quantumFeline/autocad-experiment/E-Nable - Thumb prosthesis - 2874072/images/Thumb_2.jpg

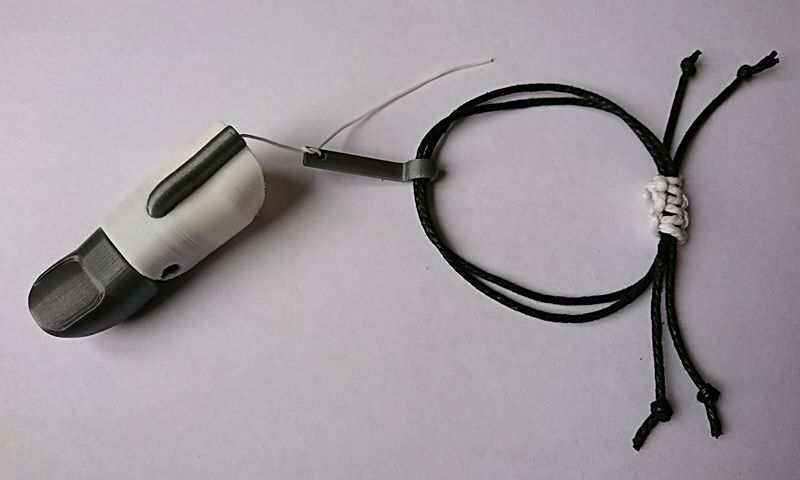
E-Nable - Thumb prosthesis - 2874072/images/Thumb_2.jpg
