quantumFeline/autocad-experiment/E-Nable - Thumb prosthesis - 2874072/images/5984bfd787b6ed34e9f9d07957b7ba69.png

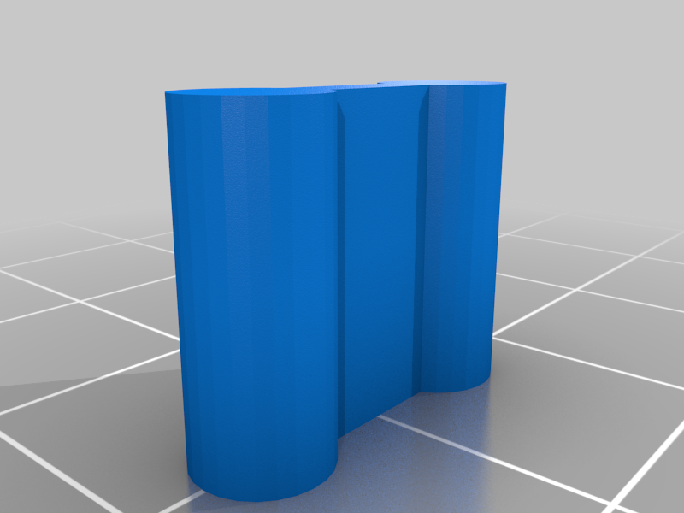
E-Nable - Thumb prosthesis - 2874072/images/5984bfd787b6ed34e9f9d07957b7ba69.png
