quantumFeline/autocad-experiment/README.md

A check whether you can vibecode something useful in autocad.
the baseline models are licensed by CC-BY-NC-SA can can be found here:
https://www.thingiverse.com/thing:2874072/files
https://www.thingiverse.com/thing:1340624/files
