quantumFeline/autocad-experiment/design/clean_sketch.png

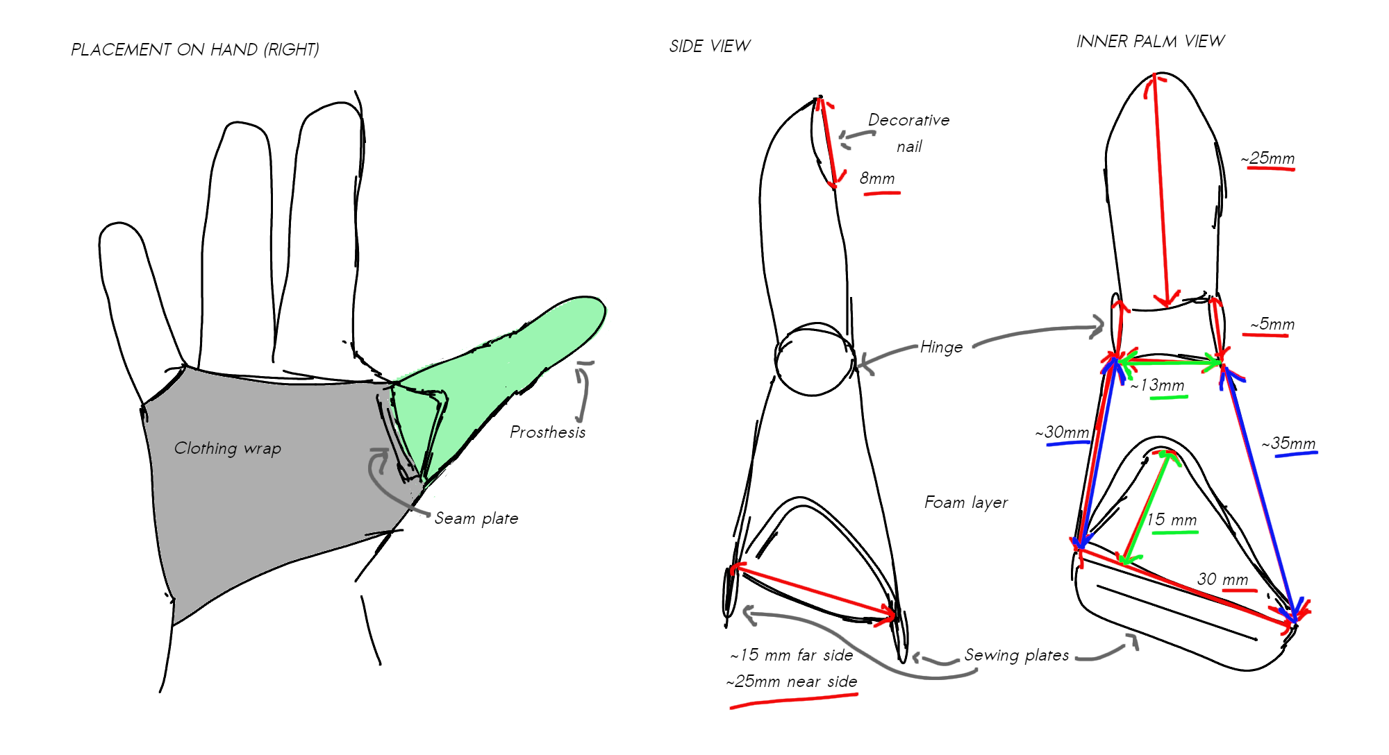
design/clean_sketch.png
