quantumFeline/autocad-experiment/design/clean_sketch_front_view.png

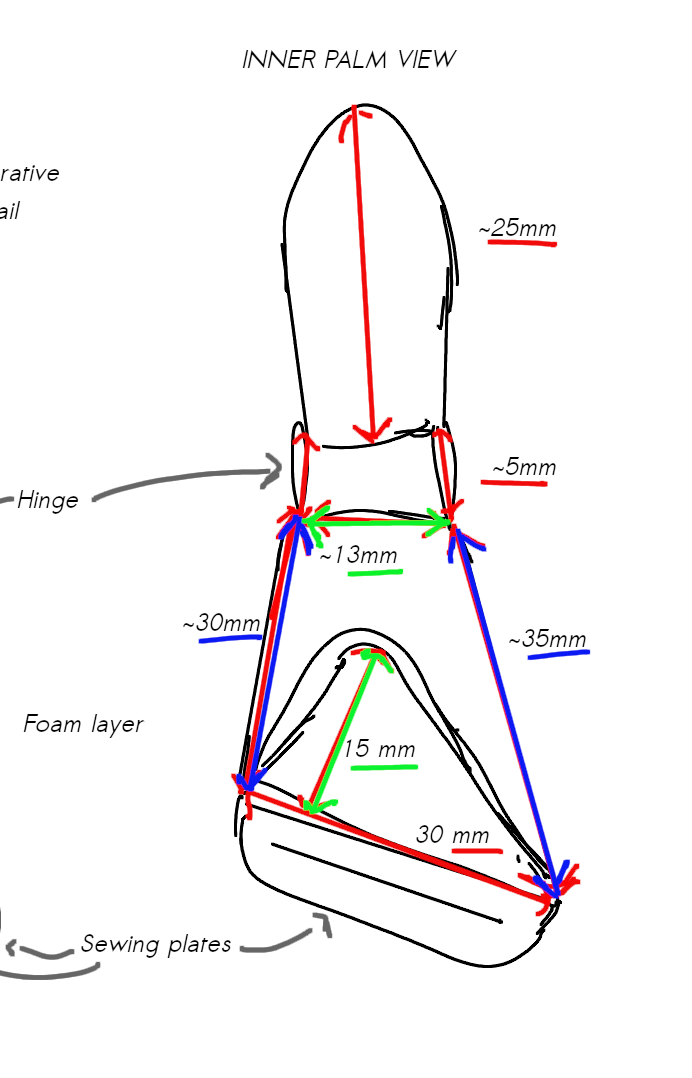
design/clean_sketch_front_view.png
