quantumFeline/autocad-experiment/design/clean_sketch_side_view.png

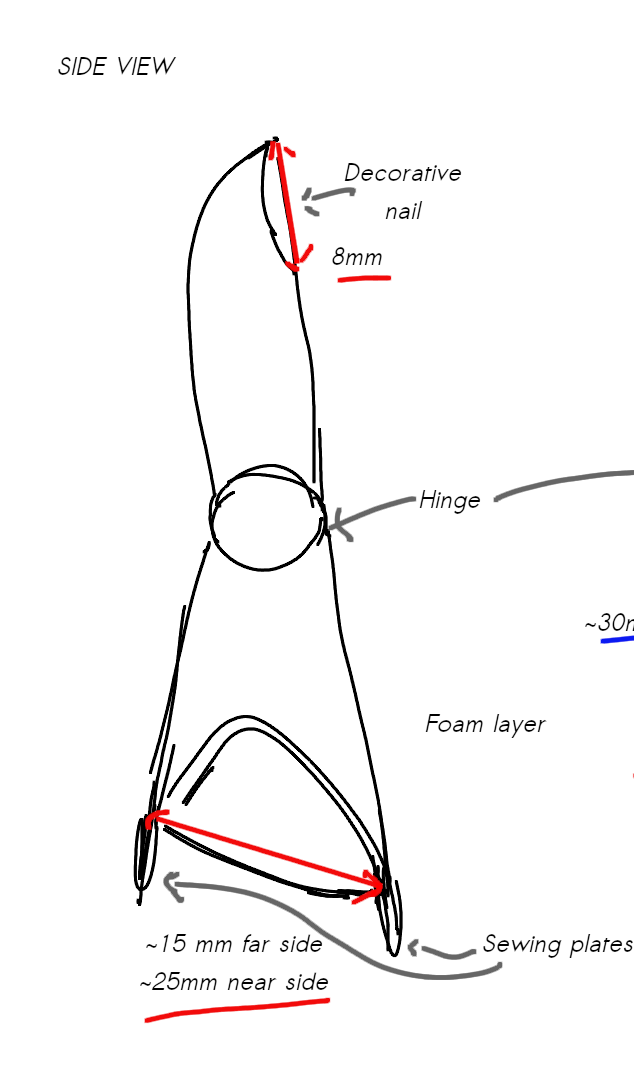
design/clean_sketch_side_view.png
