quantumFeline/autocad-experiment/design/sketch.jpeg

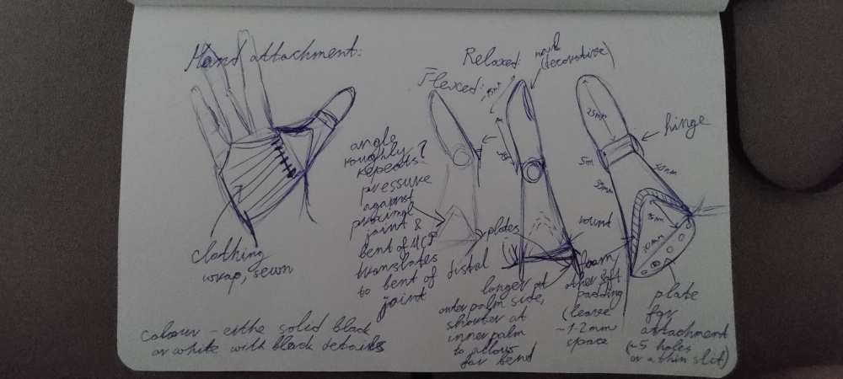
design/sketch.jpeg
