quantumFeline/autocad-experiment/E-Nable - Thumb prosthesis - 2874072/images/54ded9b1bef4dffa997f324771f008ee.png

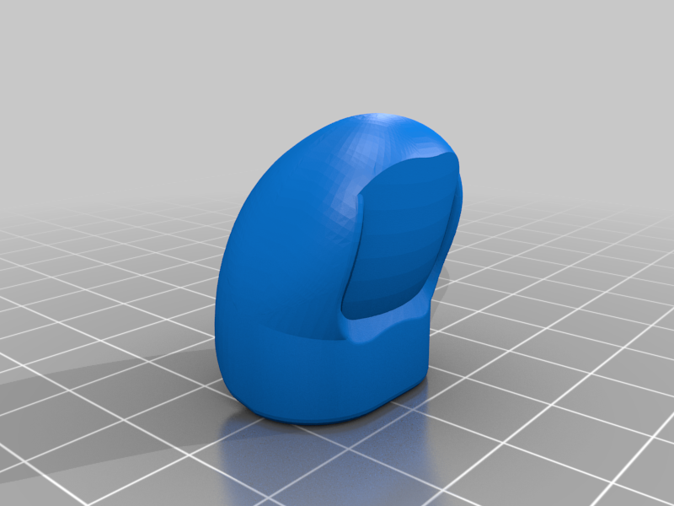
E-Nable - Thumb prosthesis - 2874072/images/54ded9b1bef4dffa997f324771f008ee.png
