quantumFeline/autocad-experiment/E-Nable - Thumb prosthesis - 2874072/images/613c3b29e1af66e0564f195f7e7fa3b6.png

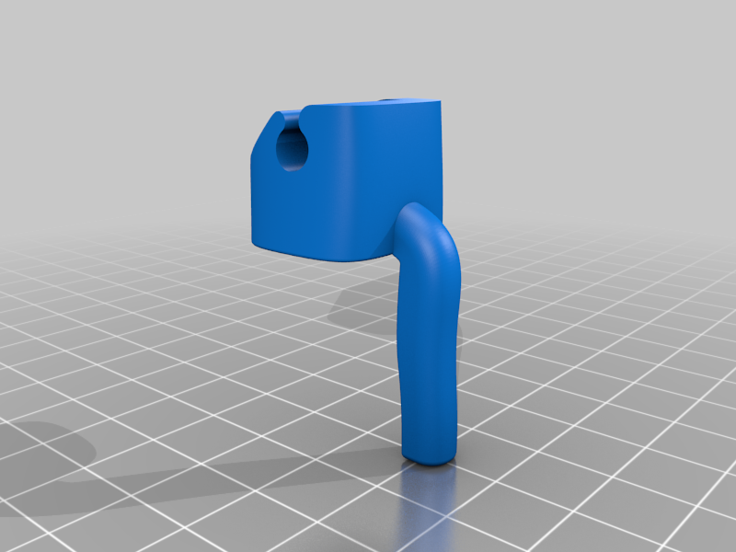
E-Nable - Thumb prosthesis - 2874072/images/613c3b29e1af66e0564f195f7e7fa3b6.png
