quantumFeline/autocad-experiment/E-Nable - Thumb prosthesis - 2874072/images/51340d938d2599c457b8b2ca0dacd941.png

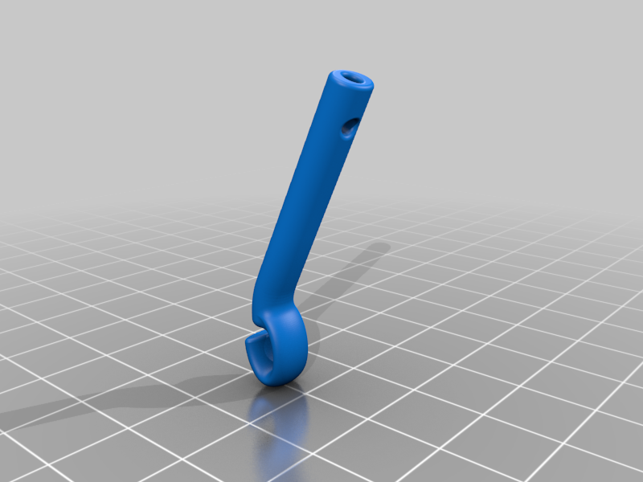
E-Nable - Thumb prosthesis - 2874072/images/51340d938d2599c457b8b2ca0dacd941.png
