quantumFeline/autocad-experiment/E-Nable - Thumb prosthesis - 2874072/images/22830366244676ff3c5c635549c43304.png

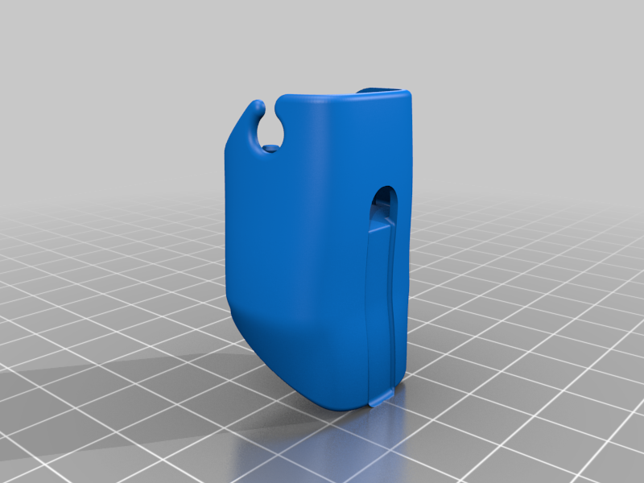
E-Nable - Thumb prosthesis - 2874072/images/22830366244676ff3c5c635549c43304.png
