quantumFeline/autocad-experiment/E-Nable - Thumb prosthesis - 2874072/images/Thumb_1.JPG

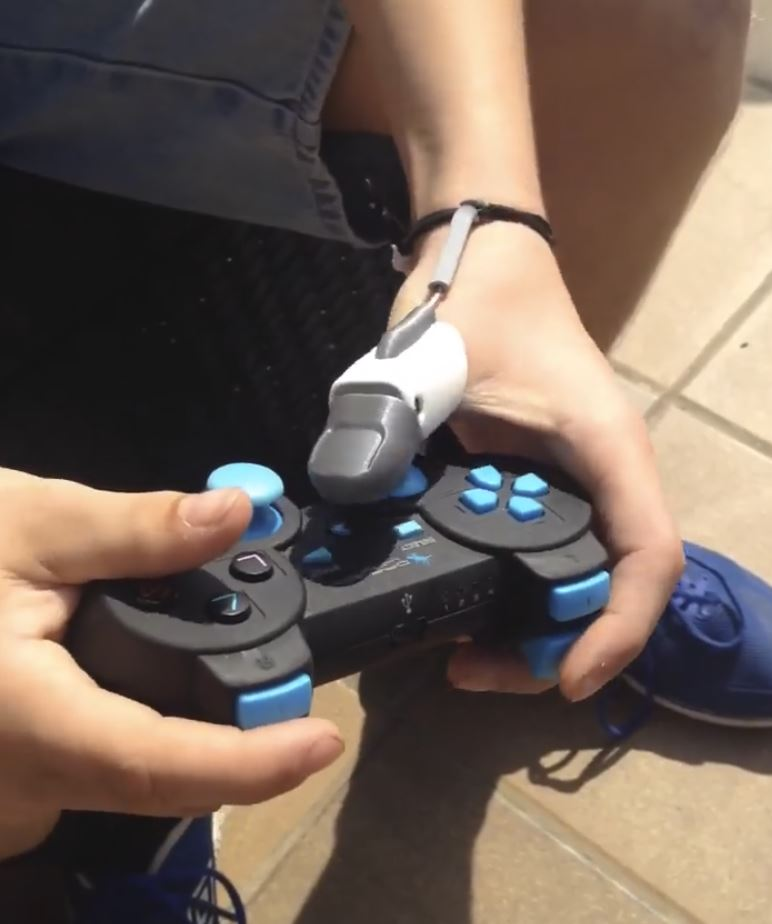
E-Nable - Thumb prosthesis - 2874072/images/Thumb_1.JPG
