quantumFeline/autocad-experiment/E-Nable - Thumb prosthesis - 2874072/images/Thumb_4.jpg

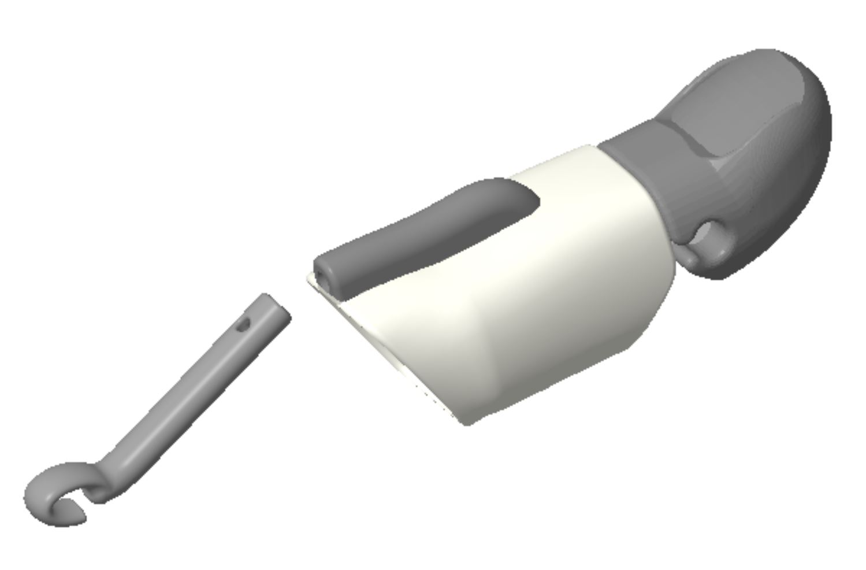
E-Nable - Thumb prosthesis - 2874072/images/Thumb_4.jpg
