quantumFeline/autocad-experiment/E-Nable - Thumb prosthesis - 2874072/images/Thumb_6.jpg

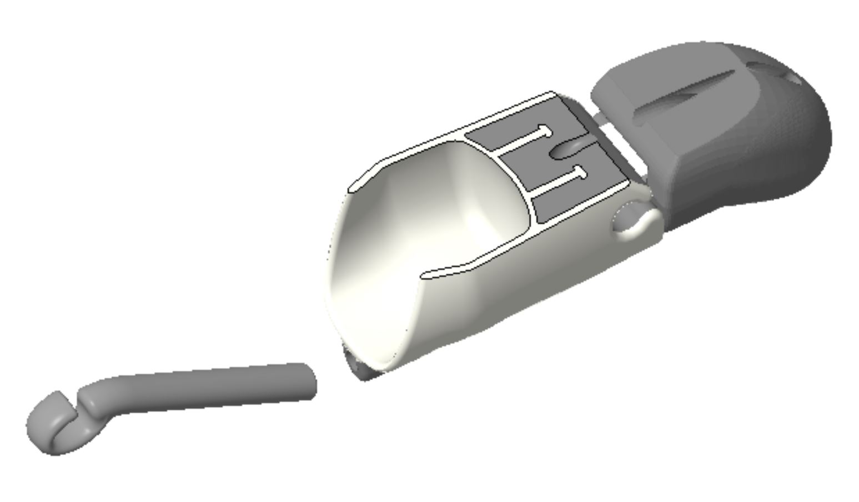
E-Nable - Thumb prosthesis - 2874072/images/Thumb_6.jpg
