quantumFeline/autocad-experiment/Knick's Prosthetic Finger v3.5.5 - 1340624/images/1c6031880f59359c41b101f5cd64a22d.png

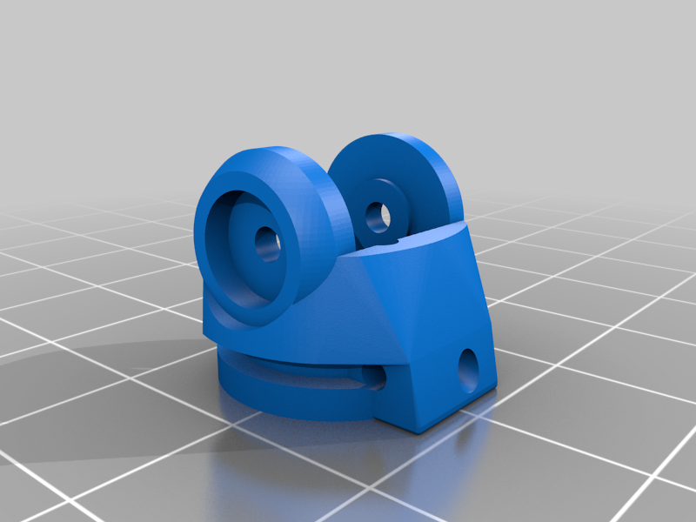
Knick's Prosthetic Finger v3.5.5 - 1340624/images/1c6031880f59359c41b101f5cd64a22d.png
