quantumFeline/autocad-experiment/Knick's Prosthetic Finger v3.5.5 - 1340624/images/5b853dfa50b55dad21bc6646ecabebe9.png

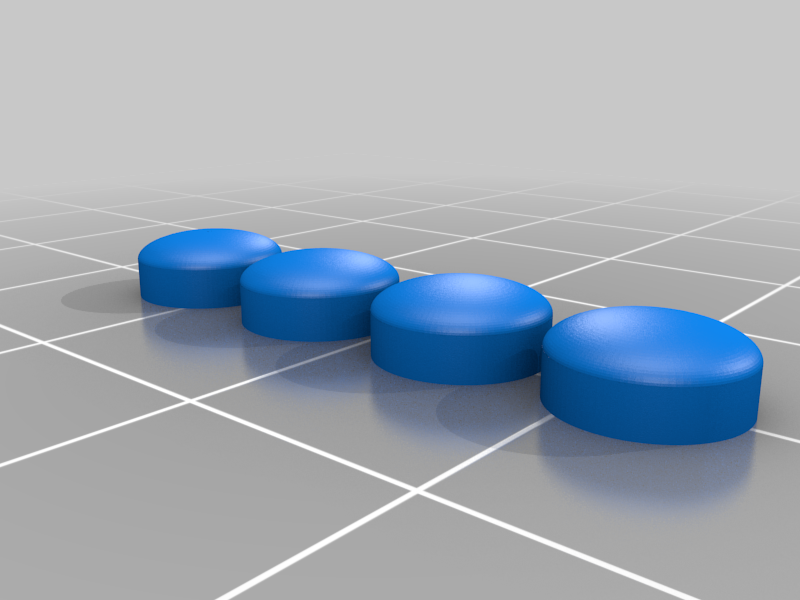
Knick's Prosthetic Finger v3.5.5 - 1340624/images/5b853dfa50b55dad21bc6646ecabebe9.png
