quantumFeline/autocad-experiment/Knick's Prosthetic Finger v3.5.5 - 1340624/images/9d57aa2e5c853061dc81193ec92a0d61.png

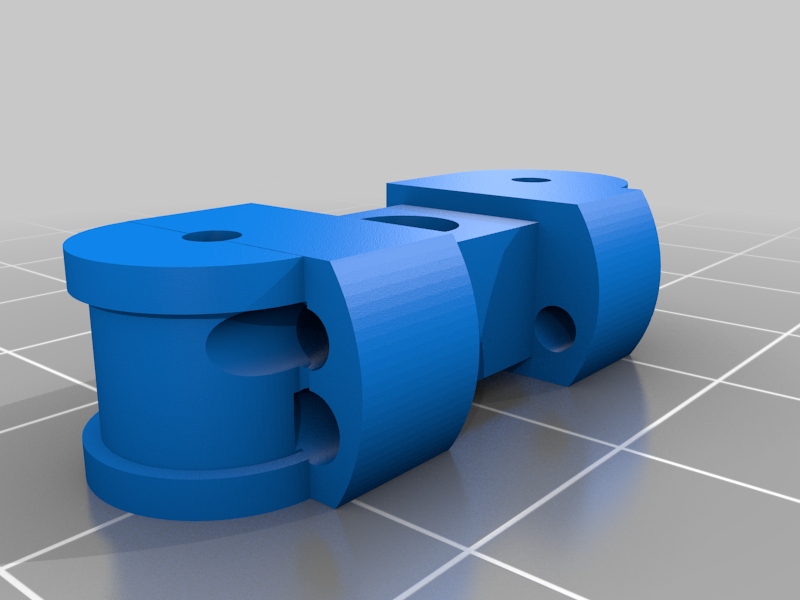
Knick's Prosthetic Finger v3.5.5 - 1340624/images/9d57aa2e5c853061dc81193ec92a0d61.png
