quantumFeline/autocad-experiment/Knick's Prosthetic Finger v3.5.5 - 1340624/images/25e89b2fef497850f5a763c68ce37bf3.png

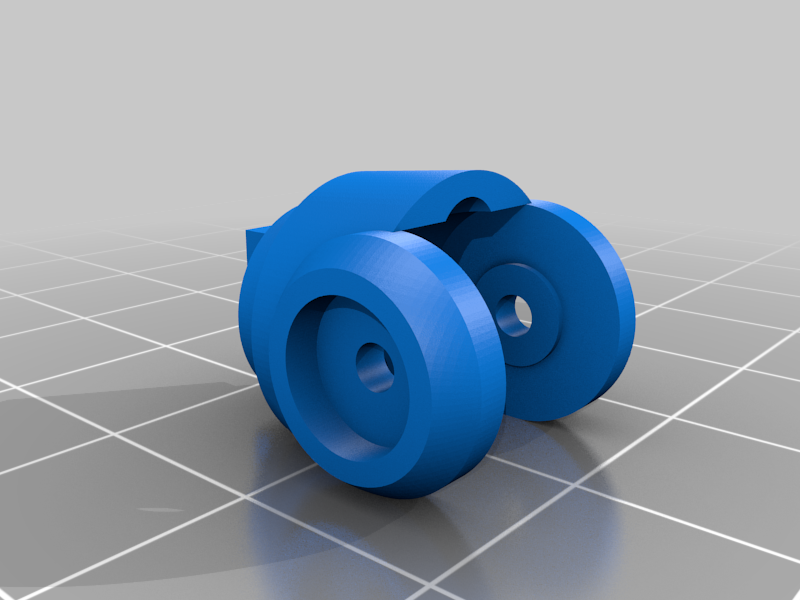
Knick's Prosthetic Finger v3.5.5 - 1340624/images/25e89b2fef497850f5a763c68ce37bf3.png
