quantumFeline/autocad-experiment/Knick's Prosthetic Finger v3.5.5 - 1340624/images/881f93b1ac3e0c698e7ac5b91a7e6feb.png

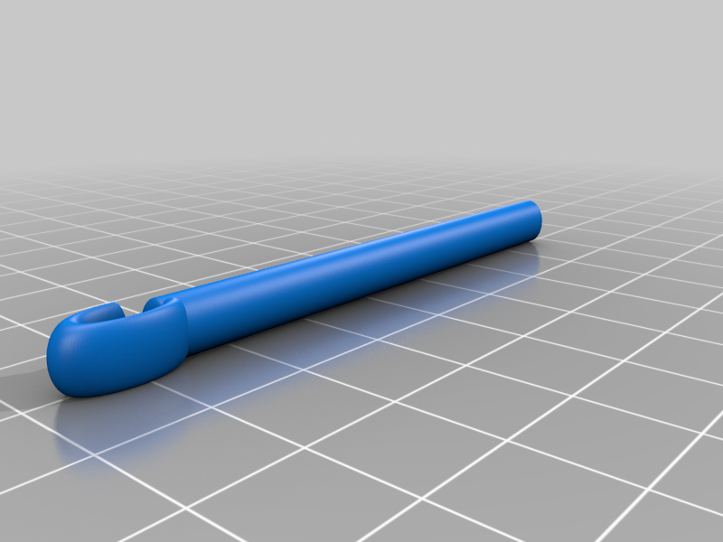
Knick's Prosthetic Finger v3.5.5 - 1340624/images/881f93b1ac3e0c698e7ac5b91a7e6feb.png
