quantumFeline/autocad-experiment/Knick's Prosthetic Finger v3.5.5 - 1340624/images/efcd1fd4c4c2df468a20345ef2f9840b.png

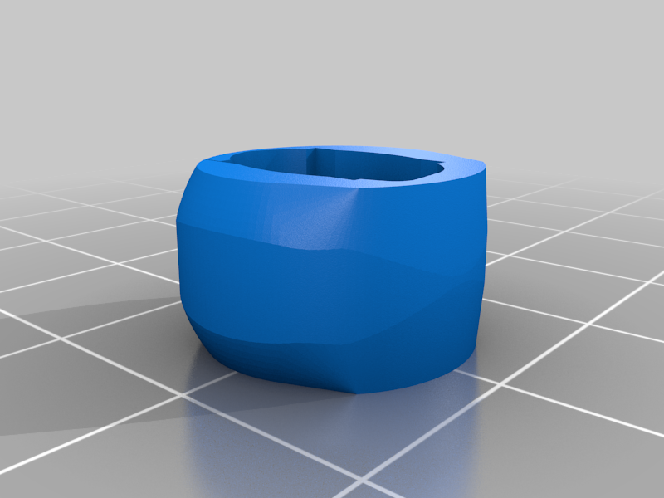
Knick's Prosthetic Finger v3.5.5 - 1340624/images/efcd1fd4c4c2df468a20345ef2f9840b.png
