quantumFeline/autocad-experiment/Knick's Prosthetic Finger v3.5.5 - 1340624/images/IMG_5169.jpg

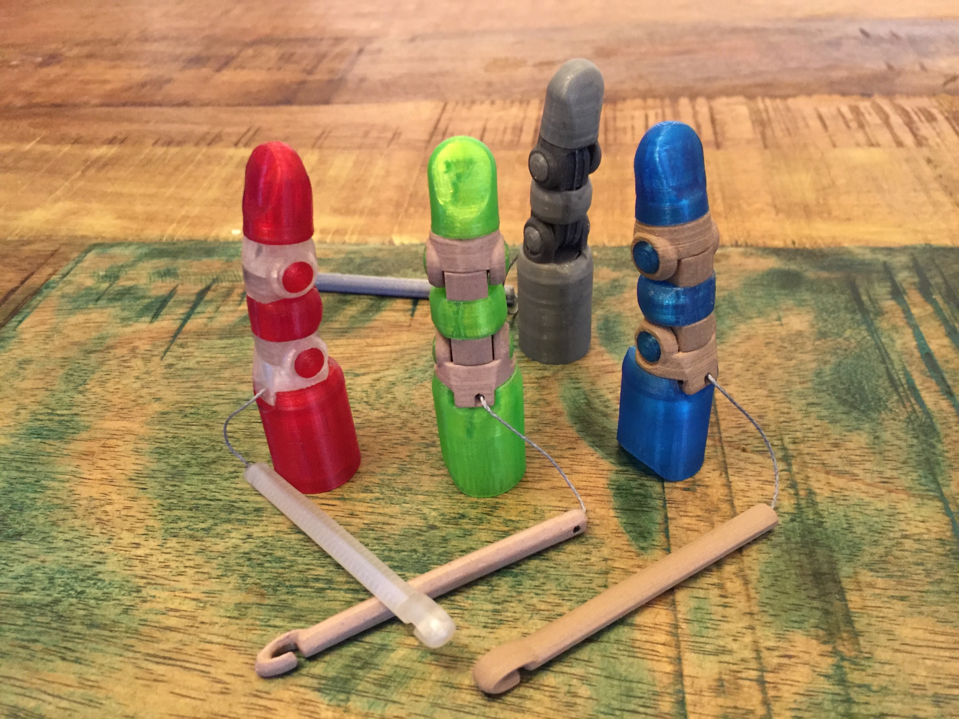
Knick's Prosthetic Finger v3.5.5 - 1340624/images/IMG_5169.jpg
