quantumFeline/autocad-experiment/Knick's Prosthetic Finger v3.5.5 - 1340624/images/Screen_Shot_2016-02-13_at_9.30.39_PM.png

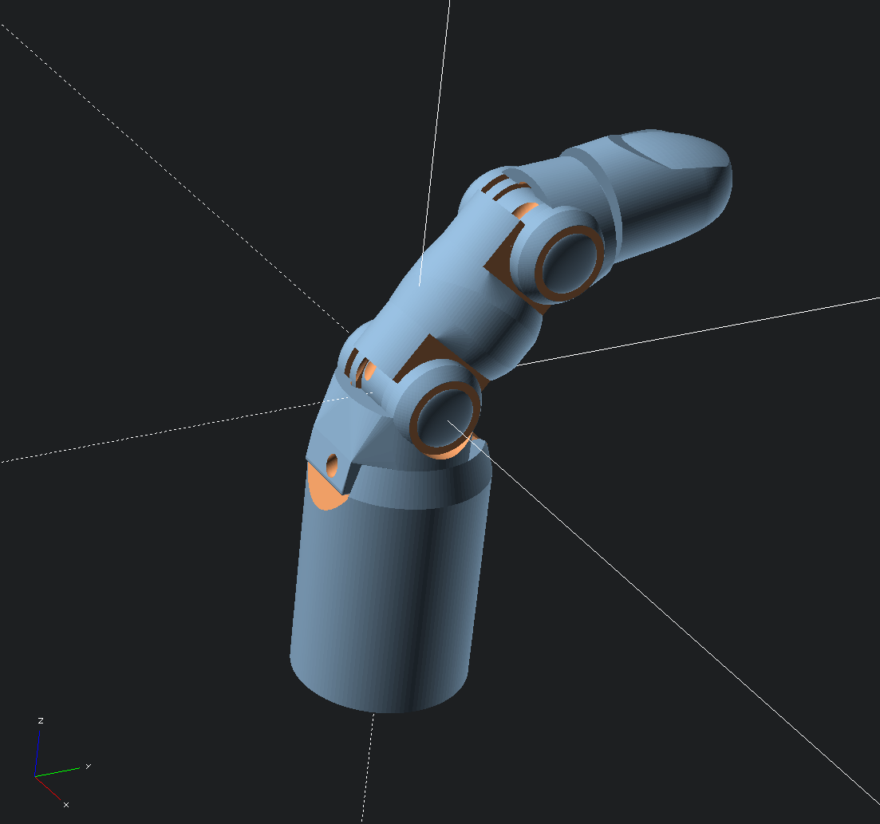
Knick's Prosthetic Finger v3.5.5 - 1340624/images/Screen_Shot_2016-02-13_at_9.30.39_PM.png
