quantumFeline/autocad-experiment/E-Nable - Thumb prosthesis - 2874072/files/thumb_prothese_v2_asm.stp

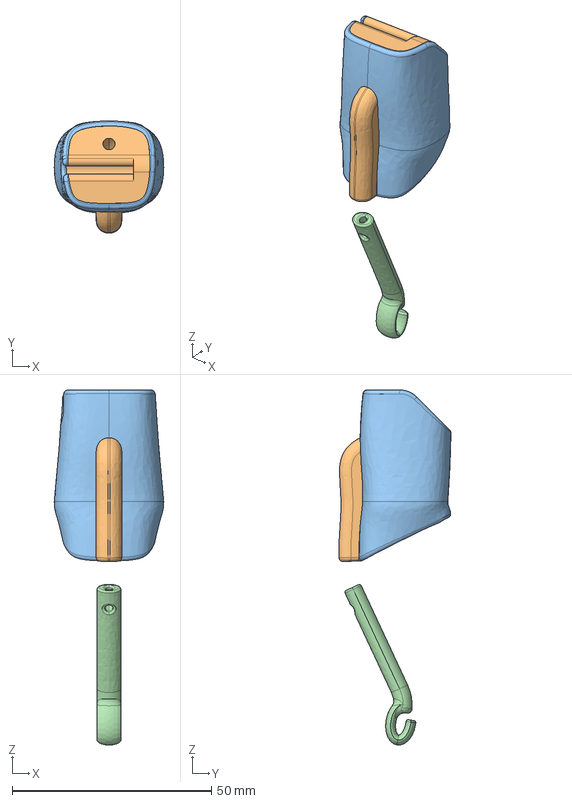
[picture p30: CAD file, 2026-07-03]
E-Nable - Thumb prosthesis - 2874072/files/thumb_prothese_v2_asm.stp
27.5 x 28.1 x 89.0 mm
THUMB_PHALANX_PLA_V2
THUMB_PHALANX_TPU_V2_
FLEXI_THUMB_PHALANX_V2
FLEXI_HINGE_8_V2
FLEXI_THUMB_V2
THUMB_LINKAGE_V2
HAND_V2
