quantumFeline/autocad-experiment/Knick's Prosthetic Finger v3.5.5 - 1340624/files/finger_plugs_v3.5.1.stl

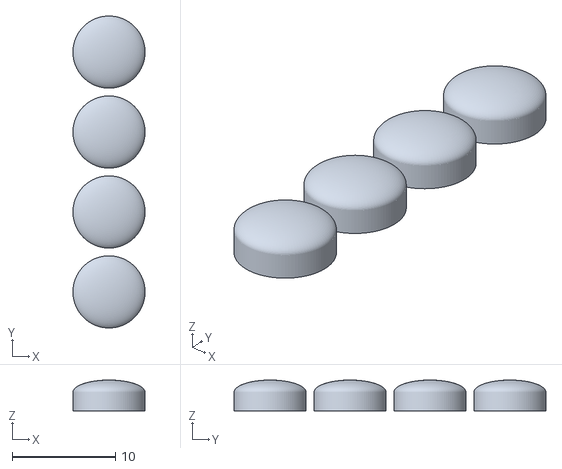
[picture p31: CAD file, 2026-07-03]
Knick's Prosthetic Finger v3.5.5 - 1340624/files/finger_plugs_v3.5.1.stl
7.00 x 30.2 x 3.00
