quantumFeline/autocad-experiment/stl/print_all.stl

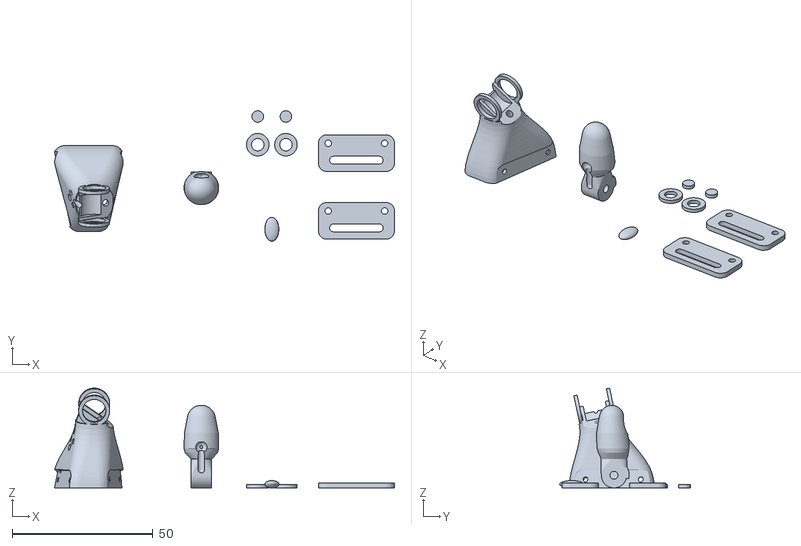
[picture p32: CAD file, 2026-08-21]
stl/print_all.stl
120.6 x 46.3 x 35.4
