quantumFeline/autocad-experiment/E-Nable - Thumb prosthesis - 2874072/files/flexi_thumb_v2.stl

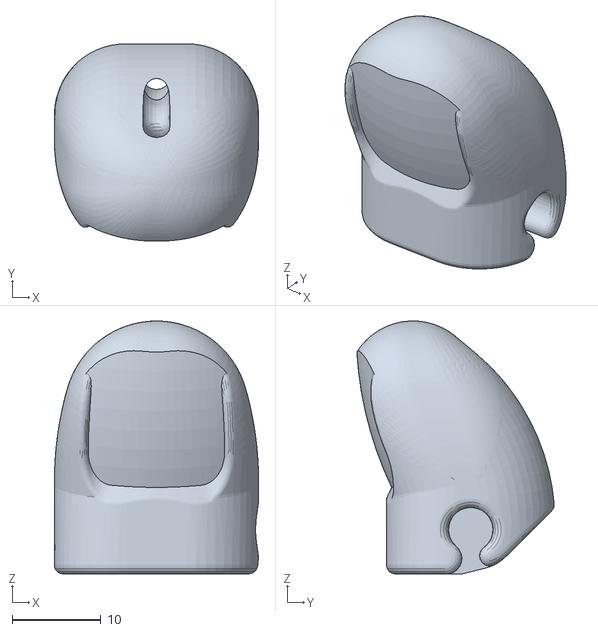
[picture p33: CAD file, 2026-07-03]
E-Nable - Thumb prosthesis - 2874072/files/flexi_thumb_v2.stl
23.0 x 22.3 x 28.5
