quantumFeline/autocad-experiment/Knick's Prosthetic Finger v3.5.5 - 1340624/files/finger_socket_v3.5.stl

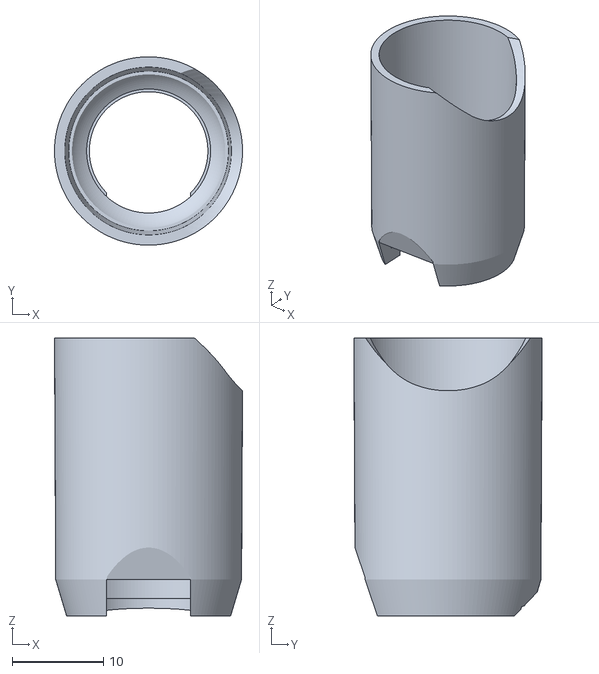
[picture p34: CAD file, 2026-07-03]
Knick's Prosthetic Finger v3.5.5 - 1340624/files/finger_socket_v3.5.stl
20.6 x 20.7 x 30.5
