quantumFeline/autocad-experiment/stl/disk_ring.stl

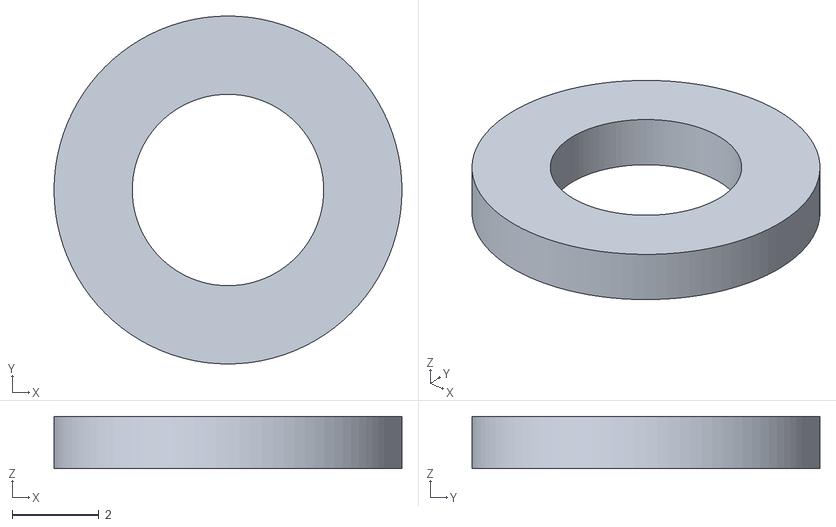
[picture p35: CAD file, 2026-08-21]
stl/disk_ring.stl
8.00 x 8.00 x 1.20
