quantumFeline/autocad-experiment/E-Nable - Thumb prosthesis - 2874072/files/flexi_hinge_8_v2.stl

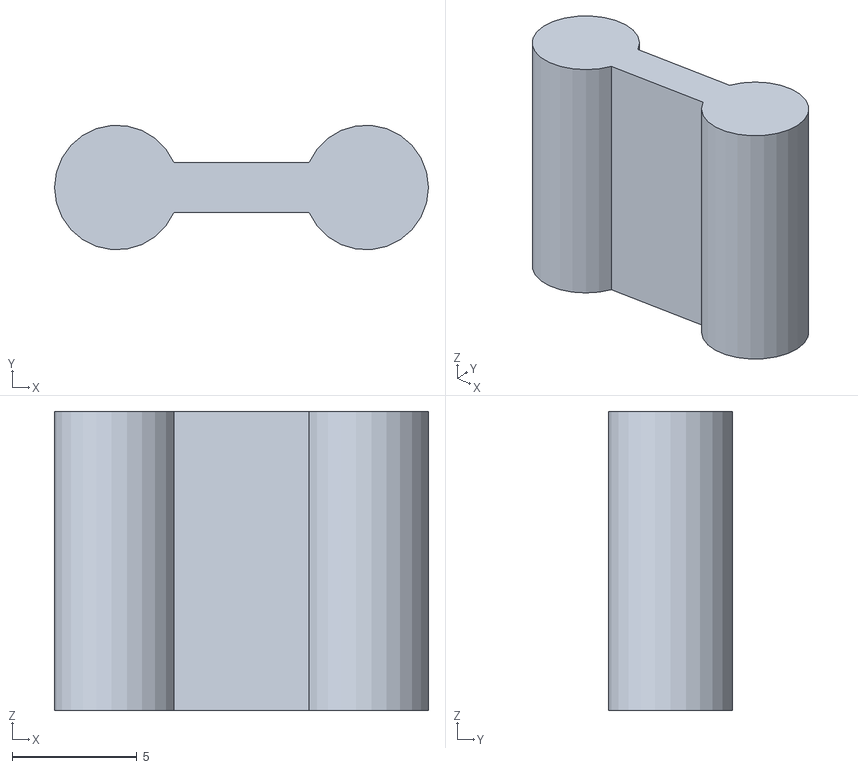
[picture p36: CAD file, 2026-07-03]
E-Nable - Thumb prosthesis - 2874072/files/flexi_hinge_8_v2.stl
15.0 x 4.99 x 12.0
