quantumFeline/autocad-experiment/Knick's Prosthetic Finger v3.5.5 - 1340624/files/finger_linkage_v3.5.stl

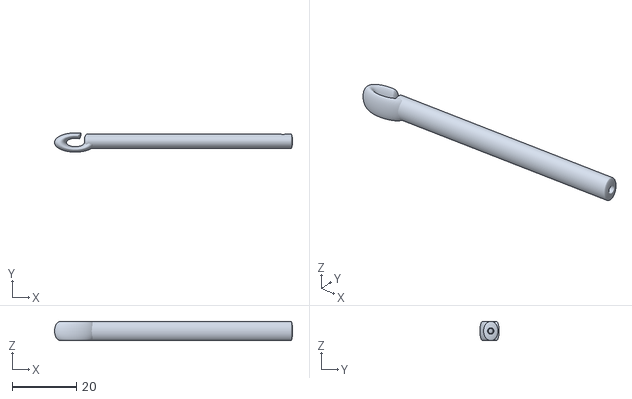
[picture p37: CAD file, 2026-07-03]
Knick's Prosthetic Finger v3.5.5 - 1340624/files/finger_linkage_v3.5.stl
74.2 x 6.00 x 6.00
