quantumFeline/autocad-experiment/stl/disk_plug.stl

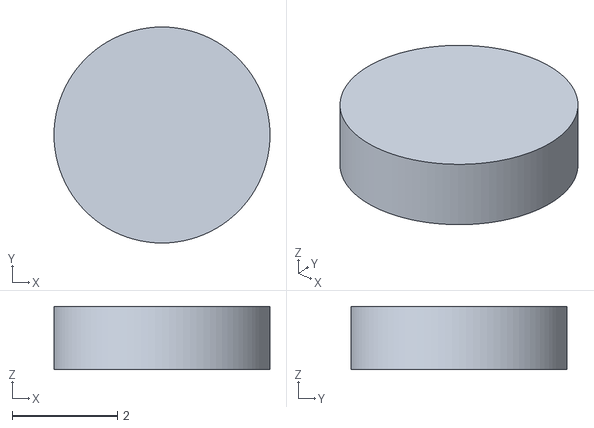
[picture p38: CAD file, 2026-08-21]
stl/disk_plug.stl
4.10 x 4.10 x 1.20
