quantumFeline/autocad-experiment/E-Nable - Thumb prosthesis - 2874072/files/thumb_linkage_v2.stl

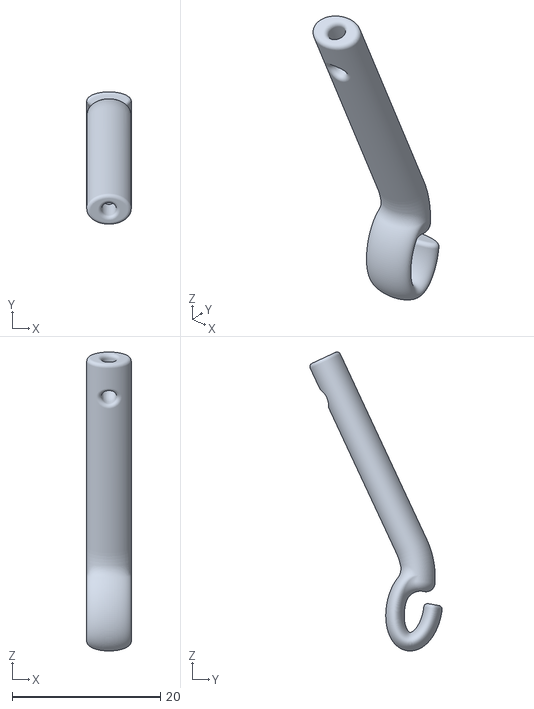
[picture p39: CAD file, 2026-07-03]
E-Nable - Thumb prosthesis - 2874072/files/thumb_linkage_v2.stl
6.00 x 17.8 x 40.3
