quantumFeline/autocad-experiment/Knick's Prosthetic Finger v3.5.5 - 1340624/files/finger_middle_v3.5.stl

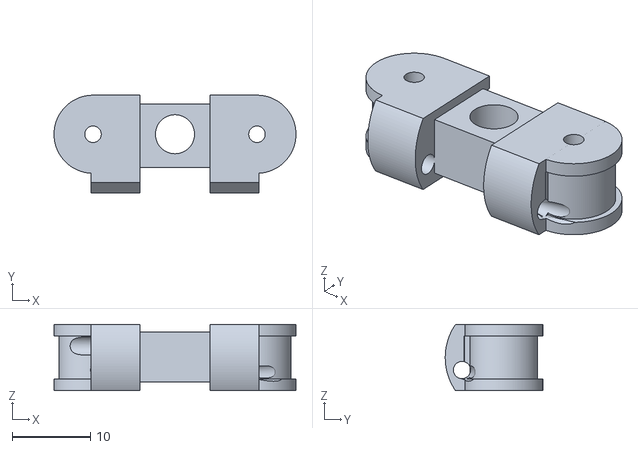
[picture p40: CAD file, 2026-07-03]
Knick's Prosthetic Finger v3.5.5 - 1340624/files/finger_middle_v3.5.stl
31.0 x 12.5 x 8.51
