quantumFeline/autocad-experiment/stl/nail.stl

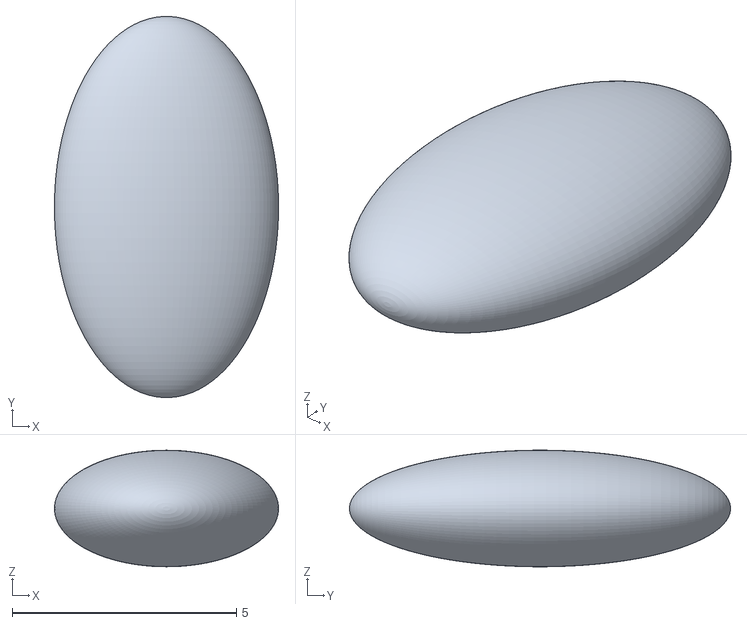
[picture p41: CAD file, 2026-08-21]
stl/nail.stl
5.00 x 8.50 x 2.60
