quantumFeline/autocad-experiment/E-Nable - Thumb prosthesis - 2874072/files/thumb_phalanx_pla_v2.stl

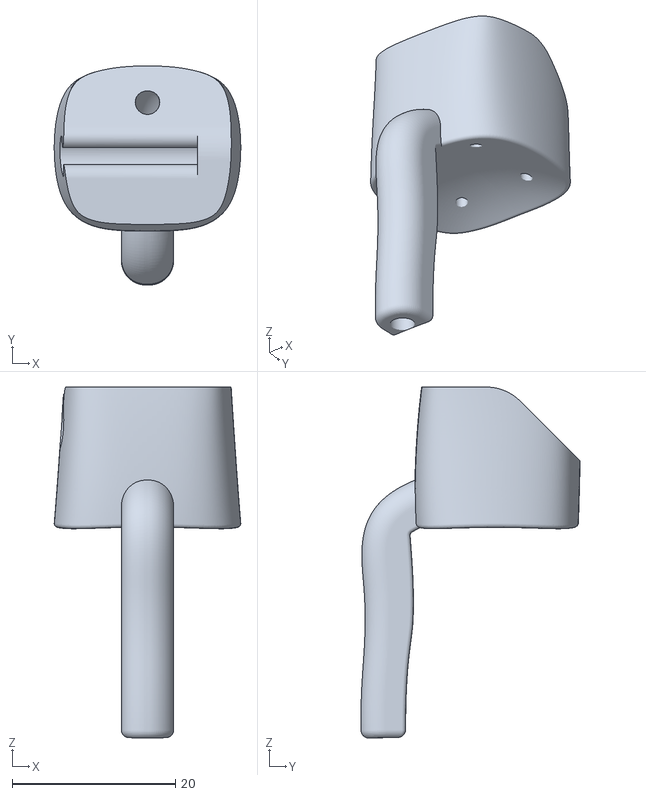
[picture p42: CAD file, 2026-07-03]
E-Nable - Thumb prosthesis - 2874072/files/thumb_phalanx_pla_v2.stl
22.8 x 26.8 x 43.0
