quantumFeline/autocad-experiment/Knick's Prosthetic Finger v3.5.5 - 1340624/files/finger_base_v3.5.stl

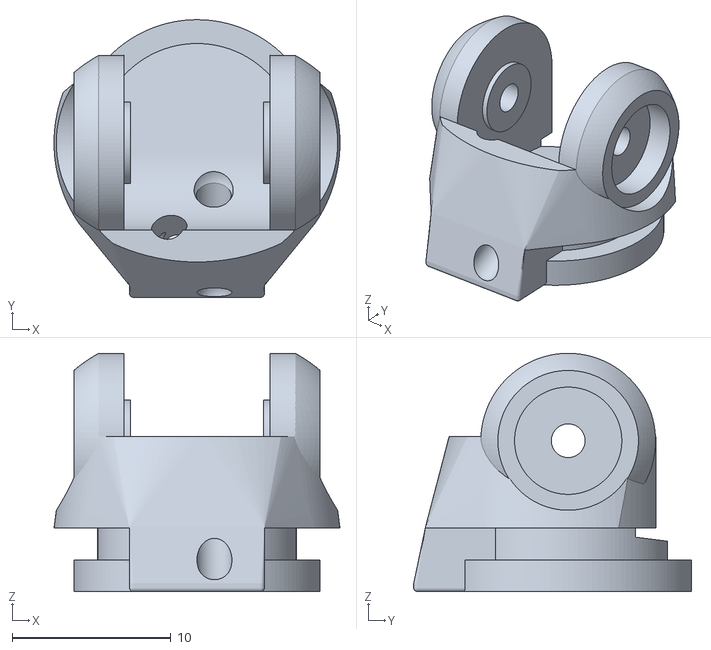
[picture p43: CAD file, 2026-07-03]
Knick's Prosthetic Finger v3.5.5 - 1340624/files/finger_base_v3.5.stl
18.0 x 17.5 x 15.0
