quantumFeline/autocad-experiment/stl/proximal.stl

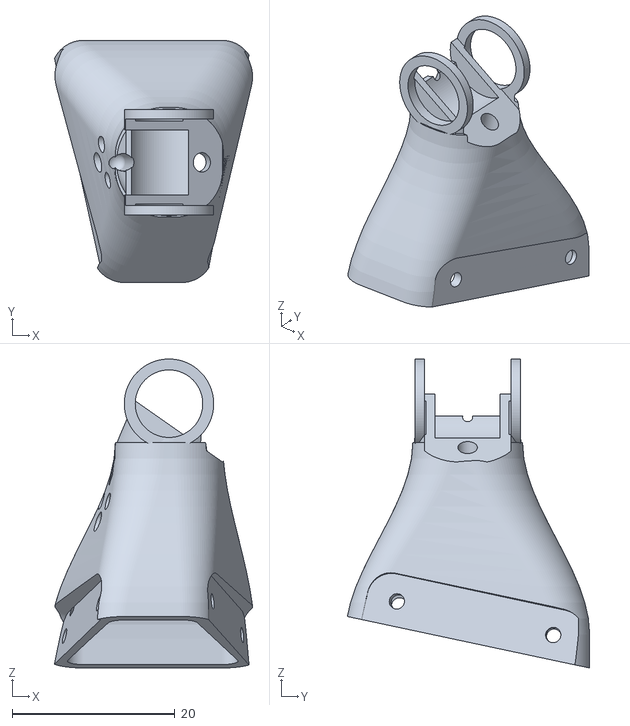
[picture p44: CAD file, 2026-08-21]
stl/proximal.stl
24.4 x 29.8 x 38.0
