quantumFeline/autocad-experiment/E-Nable - Thumb prosthesis - 2874072/files/thumb_phalanx_tpu_v2_.stl

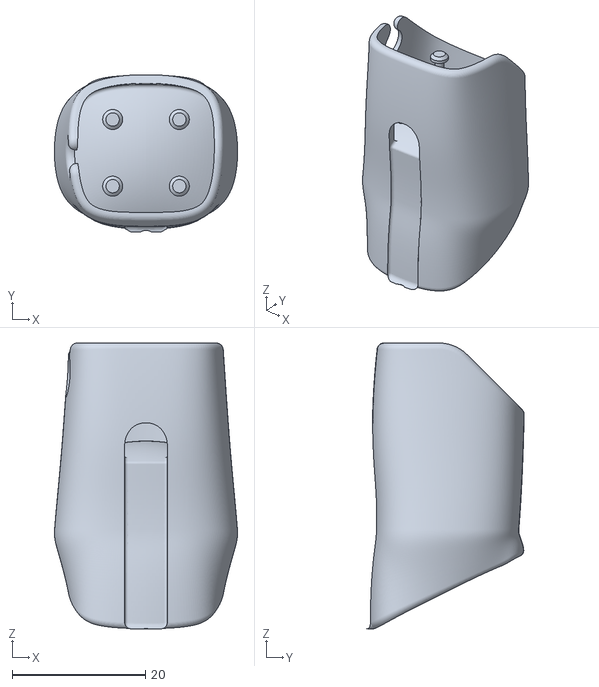
[picture p45: CAD file, 2026-07-03]
E-Nable - Thumb prosthesis - 2874072/files/thumb_phalanx_tpu_v2_.stl
27.5 x 23.6 x 42.9
