quantumFeline/autocad-experiment/Knick's Prosthetic Finger v3.5.5 - 1340624/files/finger_bumper_v3.5.stl

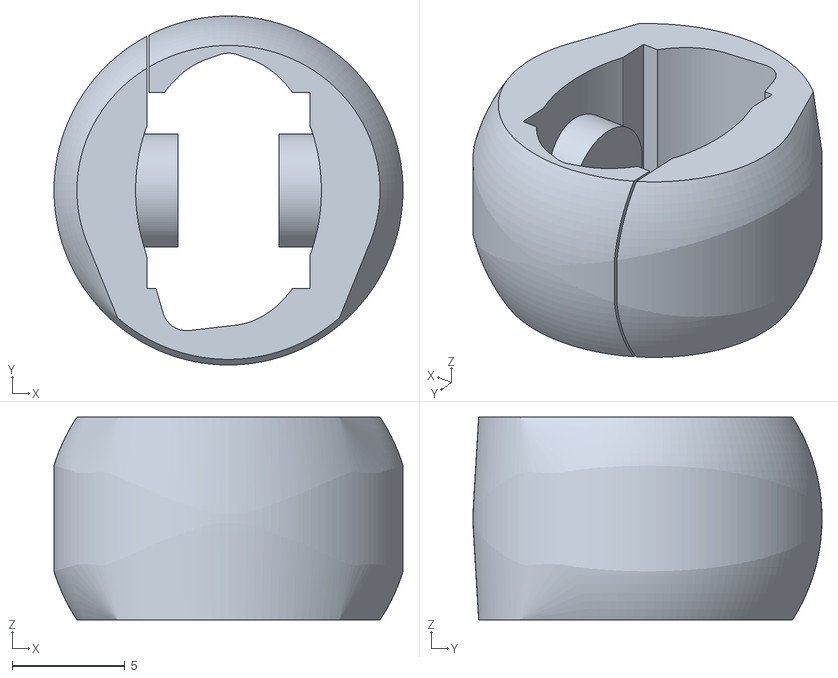
[picture p46: CAD file, 2026-07-03]
Knick's Prosthetic Finger v3.5.5 - 1340624/files/finger_bumper_v3.5.stl
15.5 x 15.5 x 9.00
