quantumFeline/autocad-experiment/stl/interference.stl

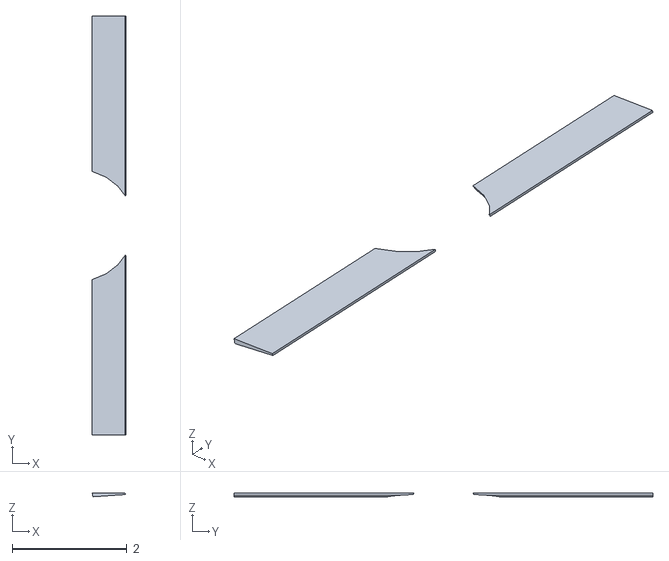
[picture p47: CAD file, 2026-08-21]
stl/interference.stl
0.584 x 7.30 x 0.0627
