quantumFeline/autocad-experiment/stl/distal.stl

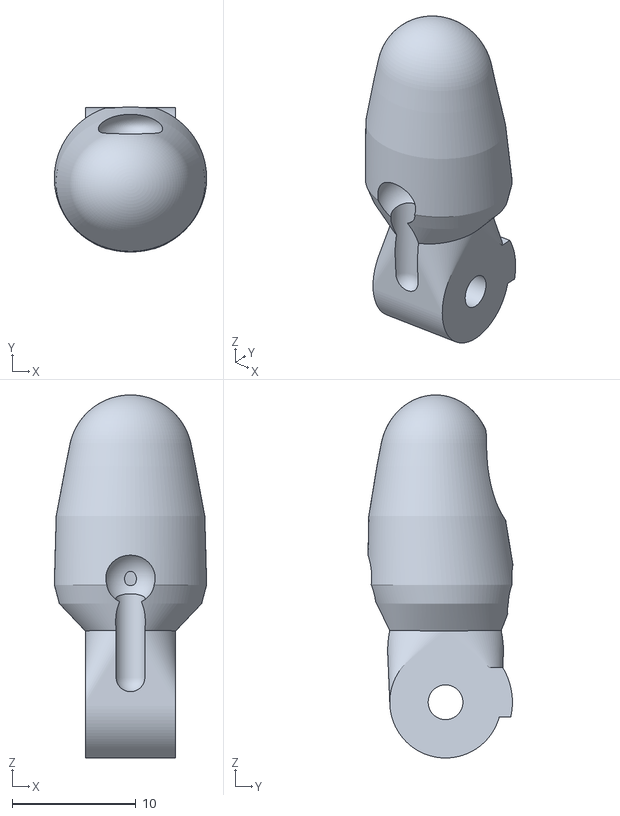
[picture p49: CAD file, 2026-08-21]
stl/distal.stl
12.3 x 11.7 x 29.3
