quantumFeline/autocad-experiment/Knick's Prosthetic Finger v3.5.5 - 1340624/files/finger_tipcover_v3.5.stl

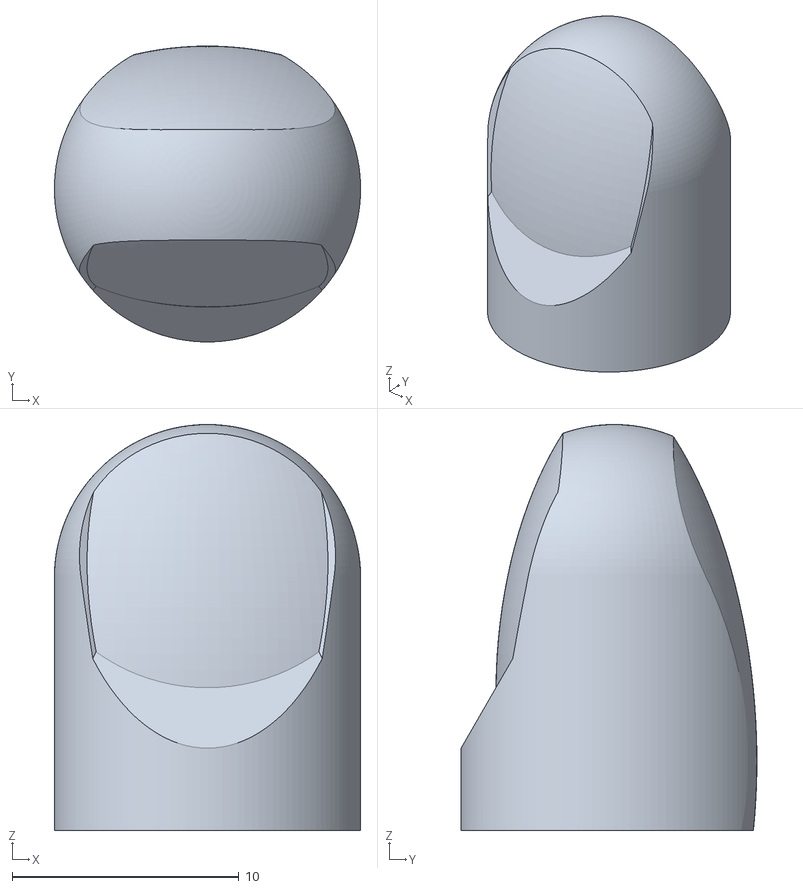
[picture p50: CAD file, 2026-07-03]
Knick's Prosthetic Finger v3.5.5 - 1340624/files/finger_tipcover_v3.5.stl
13.5 x 13.0 x 17.9
