quantumFeline/autocad-experiment/stl/plate.stl

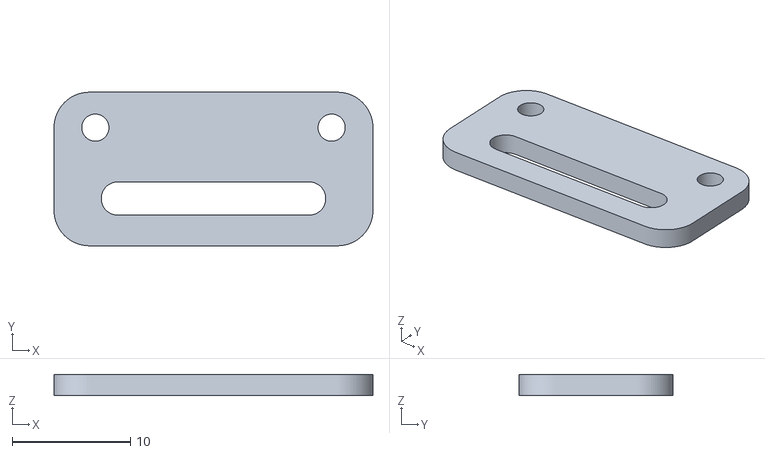
[picture p51: CAD file, 2026-08-21]
stl/plate.stl
27.0 x 13.0 x 1.80
