quantumFeline/autocad-experiment/(list of files, cad)

Other CAD files:
Knick's Prosthetic Finger v3.5.5 - 1340624/files/finger_v3.5.1.scad
Knick's Prosthetic Finger v3.5.5 - 1340624/files/finger_v3.5.2.scad
Knick's Prosthetic Finger v3.5.5 - 1340624/files/finger_v3.5.4.scad
Knick's Prosthetic Finger v3.5.5 - 1340624/files/finger_v3.5.5.scad
Knick's Prosthetic Finger v3.5.5 - 1340624/files/finger_v3.5.scad
