quantumFeline/autocad-experiment/(commit log)

2026-07-03 initiate state
    [finger_base_v3.5.stl, finger_bumper_v3.5.stl, finger_linkage_v3.5.stl, finger_middle_v3.5.stl, finger_plugs_v3.5.1.stl, finger_socket_v3.5.stl, finger_tip_v3.5.stl, finger_tipcover_v3.5.stl]
2026-07-03 version 0.1
    [thumb_mvp_v1.scad]
2026-07-03 remove seam, add soft plate, pyramid mount
    [thumb_mvp_v1.scad]
2026-07-03 more organic shape?
    [thumb_mvp_v1.scad]
2026-07-03 more snug base
    [thumb_mvp_v1.scad]
2026-07-03 thumb 2 rough draft
    [thumb_mvp_v1_frozen.scad, thumb_mvp_v2.scad]
2026-07-04 add spec
    [thumb_mvp_v2.scad]
2026-07-04 thumb v3: sketch-faithful redesign with pronated tendon-driven hinge
    New parametric design (thumb_v3.scad) built from design/spec.md and
    design/clean_sketch.png, replacing the thumb_mvp_* approach:
    - proximal = single hollow truncated pyramid (30 mm rounded wedge
    footprint, 25 mm deep at the wrist side / 15 mm at the fingers
    side, tapering to the 13 mm hinge); stump + web sit inside on a
    foam lining; bottom rim cut obliquely (rim_tilt) so the palm-back
    edge is ~5 mm longer, per the 30/35 mm front-view edges
    - fully pronated hinge (hinge_spin=90): pin along the palm normal,
    bicolour disks (black ring + white plug inlays) face palm-front/
    palm-back as in the sketch side view; dist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
    [thumb_v3.scad]
2026-07-04 thumb v3: hang sewing plates below the base rim
    Per the sketch side view, the slitted halves of the TPU plates now
    hang below the bottom opening instead of sitting mid-face: the wrap
    tension pulls the base down onto the stump (shorter lever arm, less
    rocking during adduction), and the fabric passes through the slits
    clear of the printed rim. Screw band stays on the pyramid face in a
    recessed pocket; slit and pilot holes swapped halves accordingly.
    Considered and rejected for now: threading the wrap through slits
    cut directly into the pyramid wall (single-piece, but loses the
    spec's flexible interface and puts rigid edges on the fabric);
    revisit if test fitting shows the inner plate irritati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
    [thumb_v3.scad]
2026-07-04 thumb v3: rotate the base trapezoid 90 degrees
    The footprint had the parallel 15/25 mm sides facing fingers/wrist;
    per Vero's correction they belong at palm-front/palm-back, with the
    two ~30 mm slanted sides facing the fingers and the wrist. The
    sewing plates move onto those long faces (both now 27 mm wide with
    a 19 mm slit, matching the ~30 mm strip in the sketch front view),
    and flexion consequently points at a 30 mm face as intended. This
    reading finally reconciles the sketch annotations: "15 mm far side /
    25 mm near side" are the near/far bottom edges seen along the side
    view axis, and the front-view strip is the fingers-side plate.
    Plate frames follow the plan-view convergence of the l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
    [thumb_v3.scad]
2026-07-04 thumb v3: unify the proximal into one swept profile
    The base was three glued idioms (footprint slab, corner-sphere ring,
    hand-tuned ellipsoid slices), which left a visible crease at the
    shoulder. The whole proximal is now a single cross-section profile
    (rounded trapezoid morphing into a near-circle under the knuckle)
    swept up the height with smoothstep easing, so the skirt, shoulder,
    and shaft blend without creases and the section count is one knob
    (prox_n). Removes footprint_2d/footprint_slab/corner_ring/
    base_hw_at and the tilt_frame indirection.
    Also: nail geometry split into origin-local nail_shape + nail_place
    (printable orientation for the inlay), distal_print wrapper dropped,
    print_p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
    [thumb_v3.scad]
2026-07-04 thumb v3: slender, higher nail
    Nail inlay reshaped per review: 5 x 8.5 mm outline (was 6.5 x 8),
    thinner shell (2.6 mm), centre moved up to distal_len-7 so it sits
    on the tip dome like a real thumbnail.
    [thumb_v3.scad]
2026-07-04 thumb v3: verify and fix the hinge mechanism
    Adds test_mechanism.scad, an include-based harness with an
    interference mode (boolean intersection of the proximal and the
    flexed distal; empty result = no collision) and two cutaway modes,
    plus a CLI flexion sweep used for verification.
    Fixed four defects the desk check and sweep exposed:
    - the profile sweep topped out 0.3 mm below the knuckle hub, leaving
    the proximal as two disconnected solids; the top section now
    reaches 0.5 mm into the hub
    - the extension stop never engaged: the barrel pocket (r 5.85) is
    wider than the hub (r 5.5), so no floor existed inside the hub.
    Added a dorsal buttress under the hinge whose top face is the slot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
    [test_mechanism.scad, thumb_v3.scad]
2026-07-04 thumb v3: smooth the distal tip and dress the hinge
    - tip sphere joins the distal's hull chain, removing the seam that
    cut across the upper phalange
    - the extension stop is reshaped from two floating boxes into ring
    segments concentric with the pin: a collar hugging the hub from
    below and a matching rounded heel above the gap, reading as one
    split ring around the joint that opens in flexion
    - tangent-cone blend from the pyramid top into the knuckle hub, and
    an earlier lower flare on the distal root, so both bodies wrap the
    hinge without sharp ledges; a 35 deg palmar-rotated copy of the
    slot slab relieves the floor so the root still sweeps freely
    - verified by interference sweep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
    [thumb_v3.scad]
2026-07-04 thumb v3: remove hinge protrusions via smaller barrel
    The 3/4 view showed sharp fins flanking the knuckle: corners of the
    cube slab in the hub blend hull, plus the stop collar stepping out
    radially past the cheeks.
    Root cause fix instead of dressing: the barrel shrinks to 9 mm
    (new barrel_d param) so its swing pocket (r 4.85) stays inside the
    knuckle silhouette (r 5.5). The extension stop floor now exists
    naturally inside the hub - the external collar is deleted entirely
    and the heel tucks within the knuckle circle. The blend hull uses a
    rounded ellipsoid slab instead of a cube, so no corner fins.
    Interference sweep after the change: stop engages ~-2.5 deg, free
    travel 0..78, hard limit ~8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
    [thumb_v3.scad]
2026-07-05 thumb v3: code smell pass
    - sewing_plate loses its vestigial (w, sw) parameters: every call
    site passed the same globals since the inner/outer plate pair was
    unified
    - proximal top section dims named (top_w/top_d) instead of repeated
    13.2/13.5 literals
    - preview_flex customizer range set to the verified 0..78 travel
    - fork_slot relief and side_face_frame constants annotated as
    empirically tuned (re-run the test_mechanism sweep / re-check
    renders when touching them)
    - cavity(): redundant union dropped, profile height argument
    explained
    - print_plate renamed print_all to match its selector value
    [thumb_v3.scad]
2026-07-05 thumb v3: add design notes doc
    Captures the session context that lived only in conversation:
    orientation conventions and sketch-view mapping, key design
    decisions with rejected alternatives, verified mechanism numbers
    and the sweep/debug workflow, and the open items before a test
    print.
2026-07-07 thumb v3: STL export pass
    Verify all six parts export as watertight single-shell manifolds at
    full quality ($fn=96): OpenSCAD/CGAL reports clean Nef volumes, and an
    independent edge-pairing check (every edge shared by exactly two
    triangles, no degenerate faces, positive volume) passes for proximal,
    distal, nail, disk ring, disk plug, and plate.
    Fix the print_all layout so every part rests on the bed:
    - tilt the proximal by rim_tilt so the oblique bottom rim sits flat
    (previously only the palm-back edge touched z=0)
    - stand the distal on barrel_d/2, not knuckle_d/2 (it floated 1 mm:
    the lowest point is the 9 mm barrel, not the 11 mm knuckle)
    - drop the nail from z=1.5 to its half-thickne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
    [thumb_v3.scad]
2026-07-07 thumb v3: raise prox_n to 15 (external review item 2)
    Nine loft stations left visible diagonal banding on the swept faces
    of the pyramid; fifteen renders markedly smoother in side-by-side
    comparison. Verified: proximal still a watertight single shell with
    identical bounding box; interference sweep unchanged (0/60/78 CLEAR,
    -4 collision = extension stop engaging). Full-quality proximal export
    now takes ~2 min.
    [thumb_v3.scad]
2026-07-07 thumb v3: handoff package for future editors
    - CLAUDE.md (repo): entry point auto-loaded in future sessions.
    Points at thumb_v3_notes.md, states the workflow (render-verify
    with the axis gizmo, sweep after hinge changes, commit per verified
    iteration, no merge/rebase without asking), and gives a tuning map
    separating safe fit/cosmetic parameters from mechanism-coupled ones
    that require re-running the interference sweep.
    - Makefile: make stl / check / sweep FLEX=<deg> / views / clean. The
    sweep target was validated in both directions (60 CLEAR, -4
    COLLISION) and the views targets reproduce the two sketch views.
    - scripts/check_manifold.py: the STL verifier used for the export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
2026-08-21 export stl
    [disk_plug.stl, disk_ring.stl, distal.stl, interference.stl, nail.stl, plate.stl, print_all.stl, proximal.stl]
2026-08-21 print_all stl
    [print_all.stl]
